AutentikRND/TALPHA/(list of files, drawings)

Other design files:
ALLNEWTALPHAwithExternalFlash/NewTalphaTHM.eprj
