AutentikRND/TALPHA/IR BLAST TALPHA/IR_Blast.ino

//library..................................................................................
#include <Wire.h>
#include <ESP8266WiFi.h>
#include <ESP8266HTTPClient.h>
#include <WiFiClient.h>
#include <DNSServer.h>
#include <ESP8266WebServer.h>
#include <WiFiManager.h>
#include <ArduinoJson.h>
#include <Arduino.h>
#include <IRremoteESP8266.h>
#include <IRsend.h>
//User ID
String userId = "c8879e6e-db31-44e4-905e-ee87f238076a";
//ID Device
String idDevice = "c33fdec6-2bdb-4d21-9a3e-7c37c33cc51a";

//Email Account
String email = "talpha.autentik@gmail.com";
//Email Password
String pass = "CwWl1c";
String serverName = "http://asia-southeast2-diawanpremium-6d4a9.cloudfunctions.net/lastValueOneDevicePremium";
WiFiManager wifiManager;
char node_ID[] = "IR BLAST";
float datsuhu, datrh, maksimalsuhu, minimalsuhu, maksimalrh, minimalrh;
int a = 1;
int b = 1;
const int ledin = 10;
const uint16_t kIrLed = 4;  // ESP8266 GPIO pin to use. Recommended: 4 (D2).

IRsend irsend(kIrLed);  // Set the GPIO to be used to sending the message.

// Example of data captured by IRrecvDumpV2.ino
uint16_t OFFac[349] = {706, 17746,  3206, 8770,  596, 398,  620, 1370,  506, 490,  680, 314,  506, 490,  648, 348,  506, 490,  504, 492,  620, 400,  650, 1320,  556, 460,  478, 518,  598, 1394,  556, 1434,  502, 492,  562, 1430,  506, 1486,  506, 1486,  504, 1486,  590, 1402,  592, 406,  586, 410,  648, 346,  500, 498,  626, 386,  594, 402,  676, 318,  500, 496,  558, 438,  670, 326,  592, 402,  504, 490,  560, 436,  592, 402,  506, 490,  506, 490,  598, 398,  560, 436,  674, 322,  614, 380,  500, 496,  556, 440,  584, 428,  480, 516,  620, 376,  586, 408,  618, 378,  504, 492,  680, 314,  560, 434,  504, 490,  506, 490,  562, 434,  652, 342,  506, 1486,  560, 1434,  616, 2878,  3126, 8830,  556, 1456,  598, 396,  620, 376,  586, 408,  650, 346,  588, 406,  650, 346,  616, 378,  506, 490,  562, 1428,  622, 374,  506, 490,  506, 1486,  504, 494,  558, 1434,  646, 1368,  622, 1368,  622, 1370,  502, 1488,  648, 1344,  592, 402,  560, 436,  506, 490,  622, 374,  618, 378,  504, 490,  646, 350,  502, 494,  556, 464,  476, 496,  498, 516,  478, 518,  622, 372,  650, 346,  556, 440,  558, 438,  620, 376,  620, 374,  592, 404,  506, 490,  506, 490,  504, 490,  506, 488,  506, 492,  636, 358,  504, 496,  500, 494,  500, 496,  500, 516,  478, 516,  568, 426,  644, 350,  556, 440,  704, 290,  502, 492,  560, 436,  620, 2876,  3038, 8912,  506, 1486,  506, 490,  560, 434,  504, 492,  588, 406,  502, 494,  652, 344,  636, 360,  616, 400,  566, 1424,  644, 352,  586, 408,  502, 1490,  562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
// Example Samsung A/C state captured from IRrecvDumpV2.ino
uint8_t samsungState[kSamsungAcStateLength] = {
  0x02, 0x92, 0x0F, 0x00, 0x00, 0x00, 0xF0,
  0x01, 0xE2, 0xFE, 0x71, 0x40, 0x11, 0xF0
};


void setup() {
  // put your setup code here, to run once:
  Serial.begin(115200);
  //wifiManager.setSTAStaticIPConfig(IPAddress(192, 168, 1, 200), IPAddress(192, 168, 1, 1), IPAddress(255, 255, 255, 0), IPAddress(8, 8, 8, 8));
  wifiManager.autoConnect(node_ID);
  irsend.begin();
  pinMode(ledin, OUTPUT);
#if ESP8266
  Serial.begin(115200, SERIAL_8N1, SERIAL_TX_ONLY);
#else  // ESP8266
  Serial.begin(115200, SERIAL_8N1);
#endif  // ESP8266
  Serial.println(WiFi.localIP());
  Serial.println(WiFi.macAddress());
  // irsend.sendRaw(ONhum, 71, 38);  // Send a raw data capture at 38kHz.
  // delay(500);
  // irsend.sendRaw(OFFhum, 71, 38);  // Send a raw data capture at 38kHz.
  // delay(500);
  // irsend.sendRaw(ONac, 349, 38);  // Send a raw data capture at 38kHz.
  // delay(500);
  // irsend.sendRaw(OFFac, 349, 38);  // Send a raw data capture at 38kHz.
  // delay(500);
}

void loop() {
  // put your main code here, to run repeatedly:

  if (WiFi.status() != WL_CONNECTED) {
    digitalWrite(ledin, HIGH);
    delay(50);
    digitalWrite(ledin, LOW);
    delay(200);
  }
  else {
    stream();
    digitalWrite(ledin, HIGH);
    if (datrh >= maksimalrh && a == 1) {
      Serial.println("dehum nyala");
      irsend.sendRaw(ONhum, 71, 38);  // Send a raw data capture at 38kHz.
      a = 0;
    }
    else if (datrh < minimalrh && a == 0) {
      Serial.println("dehum mati");
      irsend.sendRaw(OFFhum, 71, 38);  // Send a raw data capture at 38kHz.
      a = 1;
    }
    /*if (datsuhu >= maksimalsuhu && b == 1) {
      Serial.println("AC nyala");
      irsend.sendRaw(ONac, 349, 38);  // Send a raw data capture at 38kHz.
      b = 0;
      }
      if (datrh < minimalrh && b == 0) {
      Serial.println("AC mati");
      irsend.sendRaw(OFFac, 349, 38);  // Send a raw data capture at 38kHz.
      b = 1;
      }*/
    else {
    }
  }
  delay(200);
  digitalWrite(ledin, LOW);
}

void stream()
{
  WiFiClient client;
  HTTPClient http;

  String serverPath = serverName + "?email=talpha.autentik@gmail.com&password=CwWl1c&userId=" + userId + "&idDevice=" + idDevice;

  // Your Domain name with URL path or IP address with path
  http.begin(client, serverPath.c_str());

  // Send HTTP GET request
  int httpResponseCode = http.GET();

  if (httpResponseCode > 0) {
    Serial.print("HTTP Response code: ");
    Serial.println(httpResponseCode);
    String payload = http.getString();
    Serial.println(payload);
    DynamicJsonDocument doc(1024);
    String input = payload;
    deserializeJson(doc, input);
    JsonObject obj = doc.as<JsonObject>();
    String value = obj["value"]["data1"];
    String m = obj["max"]["max_data1"];
    String mi = obj["min"]["min_data1"];
    String value2 = obj["value"]["data2"];
    String m1 = obj["max"]["max_data2"];
    String mi1 = obj["min"]["min_data2"];
    Serial.print("json suhu");
    Serial.println(value);
    Serial.print("json rh ");
    Serial.println(value2);
    maksimalsuhu = m.toFloat();
    minimalsuhu = mi.toFloat();
    maksimalrh = m1.toFloat();
    minimalrh = mi1.toFloat();
    datsuhu = value.toFloat();
    datrh = value2.toFloat();
  }
  else {
    Serial.print("Error code: ");
    Serial.println(httpResponseCode);
  }
  // Free resources
  http.end();

}
