AutentikRND/TALPHA/ALLNEWTALPHAwithExternalFlash/icons.c

unsigned char cloud[] = {
  // 'TALPHA LOGO HD, 230x96px
  0x7f, 0xff, 0xff, 0xff, 0x80, 0x00, 0x1f, 0xf8, 0x00, 0x00, 0x3f, 0x80, 0x00, 0x00, 0x0f, 0xff,
  0xf0, 0x00, 0x00, 0x3f, 0x00, 0x00, 0x1f, 0x80, 0x00, 0x03, 0xff, 0x00, 0x00, 0xff, 0xff, 0xff,
  0xff, 0x80, 0x00, 0x1f, 0xfc, 0x00, 0x00, 0x3f, 0x80, 0x00, 0x00, 0x0f, 0xff, 0xff, 0x80, 0x00,
  0x7f, 0x00, 0x00, 0x3f, 0x80, 0x00, 0x07, 0xff, 0x00, 0x00, 0xff, 0xff, 0xff, 0xff, 0x80, 0x00,
  0x1f, 0xfc, 0x00, 0x00, 0x3f, 0x80, 0x00, 0x00, 0x0f, 0xff, 0xff, 0xe0, 0x00, 0x7f, 0x00, 0x00,
  0x3f, 0x80, 0x00, 0x07, 0xff, 0x00, 0x00, 0xff, 0xff, 0xff, 0xff, 0x80, 0x00, 0x1f, 0xfc, 0x00,
  0x00, 0x3f, 0x80, 0x00, 0x00, 0x0f, 0xff, 0xff, 0xf8, 0x00, 0x7f, 0x00, 0x00, 0x3f, 0x80, 0x00,
  0x07, 0xff, 0x80, 0x00, 0xff, 0xff, 0xff, 0xff, 0x80, 0x00, 0x3f, 0xfc, 0x00, 0x00, 0x3f, 0x80,
  0x00, 0x00, 0x0f, 0xff, 0xff, 0xfc, 0x00, 0x7f, 0x00, 0x00, 0x3f, 0x80, 0x00, 0x07, 0xff, 0x80,
  0x00, 0xff, 0xff, 0xff, 0xff, 0x80, 0x00, 0x3f, 0xfc, 0x00, 0x00, 0x3f, 0x80, 0x00, 0x00, 0x0f,
  0xff, 0xff, 0xfe, 0x00, 0x7f, 0x00, 0x00, 0x3f, 0x80, 0x00, 0x07, 0xff, 0x80, 0x00, 0xff, 0xff,
  0xff, 0xff, 0x80, 0x00, 0x3f, 0xfe, 0x00, 0x00, 0x3f, 0x80, 0x00, 0x00, 0x0f, 0xff, 0xff, 0xfe,
  0x00, 0x7f, 0x00, 0x00, 0x3f, 0x80, 0x00, 0x0f, 0xff, 0x80, 0x00, 0x00, 0x03, 0xf0, 0x00, 0x00,
  0x00, 0x3f, 0xfe, 0x00, 0x00, 0x3f, 0x80, 0x00, 0x00, 0x0f, 0xe0, 0x01, 0xff, 0x00, 0x7f, 0x00,
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
  0x00, 0x03, 0xe0, 0x00, 0x01, 0xc0, 0x00, 0x01, 0xc0, 0x00, 0x00, 0x80, 0x00, 0x00, 0x80, 0x00,
  0x00, 0x00, 0x00
};
unsigned char empty[] = {
  0xff, 0xff, 0xff, 0xe0, 0xff, 0xff, 0xff, 0xe0, 0xc0, 0x00, 0x00, 0x60, 0xc0, 0x00, 0x00, 0x7e,
  0xc0, 0x00, 0x00, 0x7e, 0xc0, 0x00, 0x00, 0x06, 0xc0, 0x00, 0x00, 0x06, 0xc0, 0x00, 0x00, 0x06,
  0xc0, 0x00, 0x00, 0x06, 0xc0, 0x00, 0x00, 0x06, 0xc0, 0x00, 0x00, 0x7e, 0xc0, 0x00, 0x00, 0x7e,
  0xc0, 0x00, 0x00, 0x60, 0xff, 0xff, 0xff, 0xe0, 0xff, 0xff, 0xff, 0xe0
};
unsigned char bar[] = {
  0xff, 0x80, 0xff, 0x80, 0xff, 0x80, 0xff, 0x80, 0xff, 0x80, 0xff, 0x80, 0xff, 0x80, 0xff, 0x80,
  0xff, 0x80, 0xff, 0x80, 0xff, 0x80
};
unsigned char charge[] = {
  0x00, 0x00, 0x00, 0x0c, 0x00, 0x3c, 0x00, 0x78, 0x00, 0xf0, 0x03, 0xe0, 0x07, 0xf8, 0x07, 0xf8,
  0x07, 0x70, 0x00, 0xe0, 0x01, 0xc0, 0x03, 0x00, 0x0e, 0x00, 0x1c, 0x00, 0x30, 0x00, 0x60, 0x00,
  0x00, 0x00
};
unsigned char warning[] = {
  0x00, 0x38, 0x7c, 0x7c, 0x7e, 0x7c, 0x7c, 0x38, 0x38, 0x38, 0x00, 0x00, 0x38, 0x38, 0x38, 0x38
};
