AutentikRND/TALPHA/(commit log)

2023-04-05 Perubahan sequence pembacaan sensor setelah get_url
2023-05-26 THM NEW
    [NewTalphaTHM.eprj]
